lgkh2002/ECE445/Notebooks/chamoun2/images/5.webp

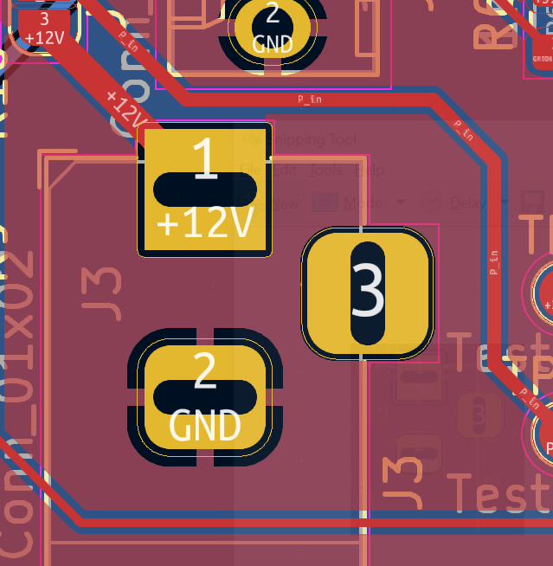
Notebooks/chamoun2/images/5.webp
