lgkh2002/ECE445/KiCad/JargonJolt/JargonJolt.kicad_pcb

## KiCad design KiCad/JargonJolt/JargonJolt.kicad_pcb (2024-04-08)

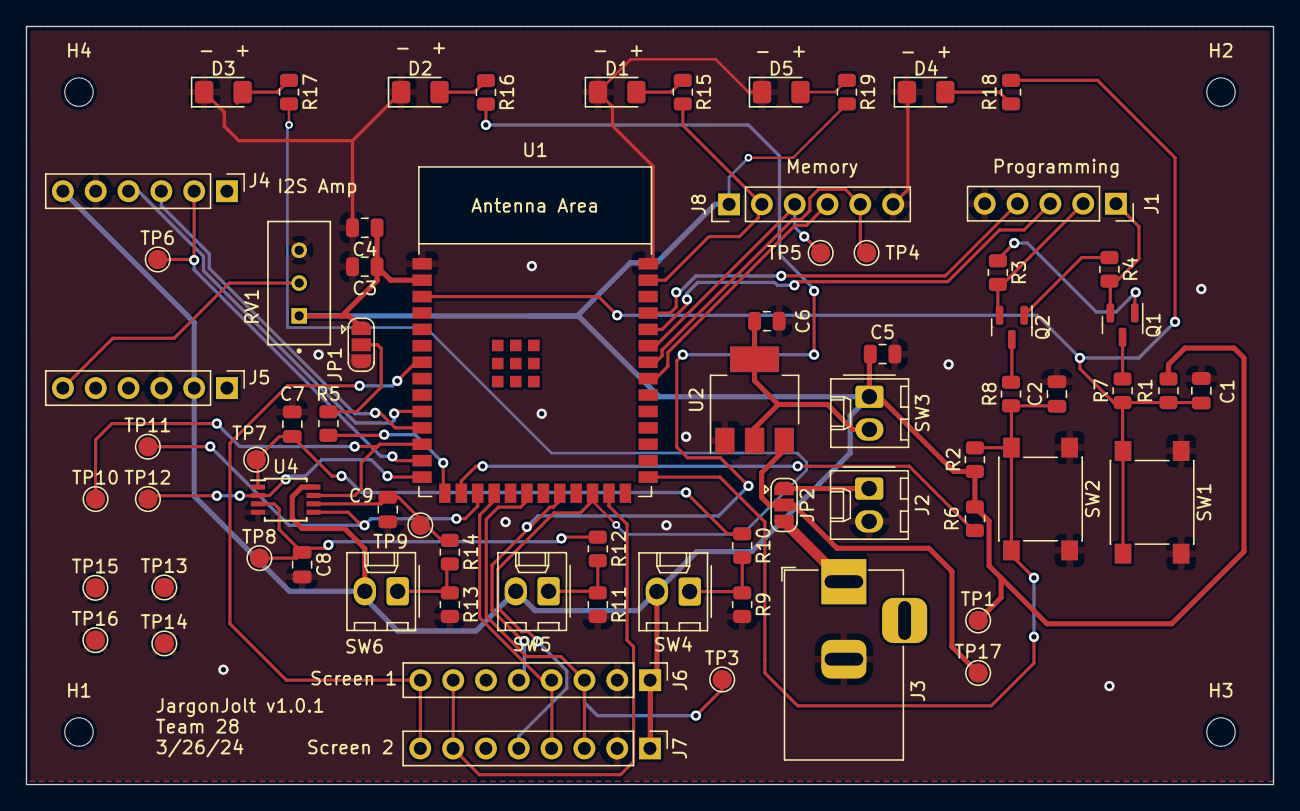
[picture p38: board JargonJolt.kicad_pcb from above]

Board: 2 copper layers, 96.5 x 58.7 mm, 75 parts (0 on the bottom side), 47 nets.

Parts:
C1, C2, C3, C5, C6: 1u; C_0805_2012Metric
C4: 0.1u; C_0805_2012Metric
C7, C8, C9: 0.1uF; C_0805_2012Metric
D1, D2, D3, D4, D5: LED; LED_1206_3216Metric_Pad1.42x1.75mm_HandSolder
H1, H2, H3, H4: MountingHole; MountingHole_2.2mm_M2
J1: Conn_01x05; PinSocket_1x05_P2.54mm_Vertical
J2: Conn_01x02; Molex_KK-254_AE-6410-02A_1x02_P2.54mm_Vertical
J3: Conn_01x02; BarrelJack_Horizontal
J4, J5, J8: Conn_01x06; PinHeader_1x06_P2.54mm_Vertical
J6, J7: Conn_01x08; PinHeader_1x08_P2.54mm_Vertical
JP1, JP2: SolderJumper_3_Open; SolderJumper-3_P1.3mm_Open_RoundedPad1.0x1.5mm
Q1, Q2: SS8050-G; SOT-23
R1, R2: 100k; R_0805_2012Metric
R3, R4, R7, R8: 10k; R_0805_2012Metric
R5, R6, R10, R12, R14: 1k; R_0805_2012Metric
R9, R11, R13: 1M; R_0805_2012Metric
R15, R16, R17, R18, R19: R; R_0805_2012Metric
RV1: 100k_Potentiometer; TRIM_3296W-1-104LF
SW1, SW2: SW_Push; SW_Push_1P1T_NO_6x6mm_H9.5mm
SW3: SW_DIP_x01; Molex_KK-254_AE-6410-02A_1x02_P2.54mm_Vertical
SW4, SW5, SW6: SW_Push; Molex_KK-254_AE-6410-02A_1x02_P2.54mm_Vertical
TP1, TP3, TP4, TP5, TP6, TP7, TP8, TP9, TP10, TP11, TP12, TP13, TP14, TP15, TP16, TP17: TestPoint; TestPoint_Pad_D1.5mm
U1: ESP32-S3-WROOM-1-N16R2; ESP32-S3-WROOM-1
U2: ADP3339; SOT-223-3_TabPin2
U4: 74LVC3G17DP_125; TSSOP-8_3x3mm_P0.65mm

Connections:
+3.3V: C6.1, SW3.2, U2.2 (VO)
+3.3VA: C3.1, C4.1, C5.1, J4.6, J5.2, J6.1, J7.1, J8.1, JP1.1 (A), R1.1, R2.1, R6.1, R19.2, RV1.1, SW3.1, SW4.2, SW5.2, SW6.2, TP1.1, U1.2 (3V3), U4.8 (VCC)
+12V: J3.1, JP2.3 (B)
/MCU/BUSY: J6.8, J7.8, U1.7 (IO7)
/MCU/BUTTON1: TP10.1, U1.12 (IO8), U4.7 (1Y)
/MCU/BUTTON2: TP11.1, U1.17 (IO9), U4.5 (2Y)
/MCU/BUTTON3: TP12.1, U1.14 (IO20), U4.2 (3Y)
/MCU/CHIP_PU: C1.1, R1.2, R7.1, R18.2, SW1.2, U1.3 (EN)
/MCU/CS0: J8.2, R15.2, U1.39 (IO1)
/MCU/CS1: J6.5, R16.2, U1.22 (IO14)
/MCU/CS2: J7.5, R17.2, U1.24 (IO47)
/MCU/DTR: J1.2, Q2.2 (E), R3.2
/MCU/GPIO0_STRAP: C2.1, R2.2, R8.1, SW2.2, U1.27 (IO0)
/MCU/GPIO3_STRAP: R5.2, U1.15 (IO3)
/MCU/GPIO46_STRAP: R6.2, U1.16 (IO46)
/MCU/HSPI_MOSI: J6.3, J7.3, TP3.1, U1.20 (IO12)
/MCU/HSPI_SCLK: J6.4, J7.4, U1.18 (IO10)
/MCU/I2S_BCLK: J4.3, U1.11 (IO18)
/MCU/I2S_DATA: J4.2, TP6.1, U1.13 (IO19)
/MCU/I2S_LRCLK: J4.4, U1.10 (IO17)
/MCU/RST: J6.7, J7.7, U1.25 (IO48)
/MCU/RTS: J1.1, Q1.2 (E), R4.2
/MCU/Rx: J1.4, U1.37 (TXD0)
/MCU/Tx: J1.3, U1.36 (RXD0)
/MCU/VSPI_MISO: J8.5, TP4.1, U1.34 (IO41)
/MCU/VSPI_MOSI: J8.3, TP5.1, U1.35 (IO42)
/MCU/VSPI_SCLK: J8.4, U1.33 (IO40)
/Power/+3.7V: J2.1, JP2.1 (A)
/Power/P_in: JP2.2 (C), TP17.1, U2.3 (VI)
GND: C1.2, C2.2, C3.2, C4.2, C5.2, C6.2, C7.2, C8.2, C9.2, D1.1 (K), D2.1 (K), D3.1 (K), D4.1 (K), D5.1 (K), J1.5, J2.2, J3.2, J4.5, J5.3, J6.2, J7.2, J8.6, JP1.3 (B), R9.2, R11.2, R13.2, RV1.3, SW1.1, SW2.1, TP13.1, TP14.1, TP15.1, TP16.1, U1.1 (GND), U1.40 (GND), U2.1 (GND), U4.4 (GND)
unnamed: D1.2 (A), R15.1
unnamed: D2.2 (A), R16.1
unnamed: D3.2 (A), R17.1
unnamed: D4.2 (A), R18.1
unnamed: D5.2 (A), R19.1
unnamed: J5.6, RV1.2
unnamed: JP1.2 (C), R5.1
unnamed: Q1.1 (B), R3.1
unnamed: Q1.3 (C), R7.2
unnamed: Q2.1 (B), R4.1
unnamed: Q2.3 (C), R8.2
unnamed: R9.1, R10.2, SW4.1
unnamed: R11.1, R12.2, SW5.1
unnamed: R13.1, R14.2, SW6.1
unnamed: C7.1, R10.1, TP7.1, U4.1 (1A)
unnamed: C8.1, R12.1, TP8.1, U4.3 (2A)
unnamed: C9.1, R14.1, TP9.1, U4.6 (3A)
