lgkh2002/ECE445/(commit log)

2024-02-16 added specific esp32 module into KiCad
    [JargonJolt.kicad_pcb, JargonJolt.kicad_sch]
2024-02-16 added jargonjolt library
    [JargonJolt.kicad_pcb, JargonJolt.kicad_sch]
2024-02-19 began working on schematic
    [JargonJolt.kicad_pcb, JargonJolt.kicad_sch, mcu.kicad_sch, memory.kicad_sch, power.kicad_sch, ui.kicad_sch]
2024-02-22 worked on pinout
    [JargonJolt.kicad_sch, mcu.kicad_sch, memory.kicad_sch, ui.kicad_sch]
2024-02-28 worked on schematic
    [JargonJolt.kicad_sch, mcu.kicad_sch, memory.kicad_sch, power.kicad_sch, ui.kicad_sch]
2024-03-01 added i2s schematic
    [JargonJolt.kicad_sch, mcu.kicad_sch, memory.kicad_sch, ui.kicad_sch]
2024-03-01 added sd module + fixed CS pins
    [JargonJolt.kicad_sch, mcu.kicad_sch, memory.kicad_sch, power.kicad_sch, ui.kicad_sch]
2024-03-02 added more footprints
    [JargonJolt.kicad_pcb, JargonJolt.kicad_sch, mcu.kicad_sch, memory.kicad_sch, ui.kicad_sch]
2024-03-04 PCB first revision
    [JargonJolt.kicad_pcb, JargonJolt.kicad_sch, mcu.kicad_sch, power.kicad_sch, ui.kicad_sch]
2024-03-05 audit approved
    [JargonJolt-B_Cu.gbr, JargonJolt-B_Mask.gbr, JargonJolt-B_Paste.gbr, JargonJolt-B_Silkscreen.gbr, JargonJolt-Edge_Cuts.gbr, JargonJolt-F_Cu.gbr, JargonJolt-F_Mask.gbr, JargonJolt-F_Paste.gbr]
2024-03-24 changed barrel connector to have proper pinout
    [JargonJolt.kicad_pcb]
2024-03-26 added test leds
    [JargonJolt.kicad_pcb, JargonJolt.kicad_sch, mcu.kicad_sch, memory.kicad_sch, power.kicad_sch, ui.kicad_sch]
2024-03-26 added 3.3v test led
    [JargonJolt.kicad_pcb, mcu.kicad_sch]
2024-03-26 v1.0.1 audit approved
    [JargonJolt-B_Cu.gbl, JargonJolt-B_Mask.gbs, JargonJolt-B_Paste.gbp, JargonJolt-B_Silkscreen.gbo, JargonJolt-Edge_Cuts.gm1, JargonJolt-F_Cu.gtl, JargonJolt-F_Mask.gts, JargonJolt-F_Paste.gtp]
2024-04-08 update esp screen code
    [JargonJolt.kicad_pcb]
2024-04-08 add arduino code for the screen
2024-04-10 upload esp32 code version for the screen
2024-04-14 word wrap in esp32
2024-05-02 insert picture in notebook
2024-05-02 insert more images
